makislam/ME100-Toy-Design/inner sleeve.SLDPRT

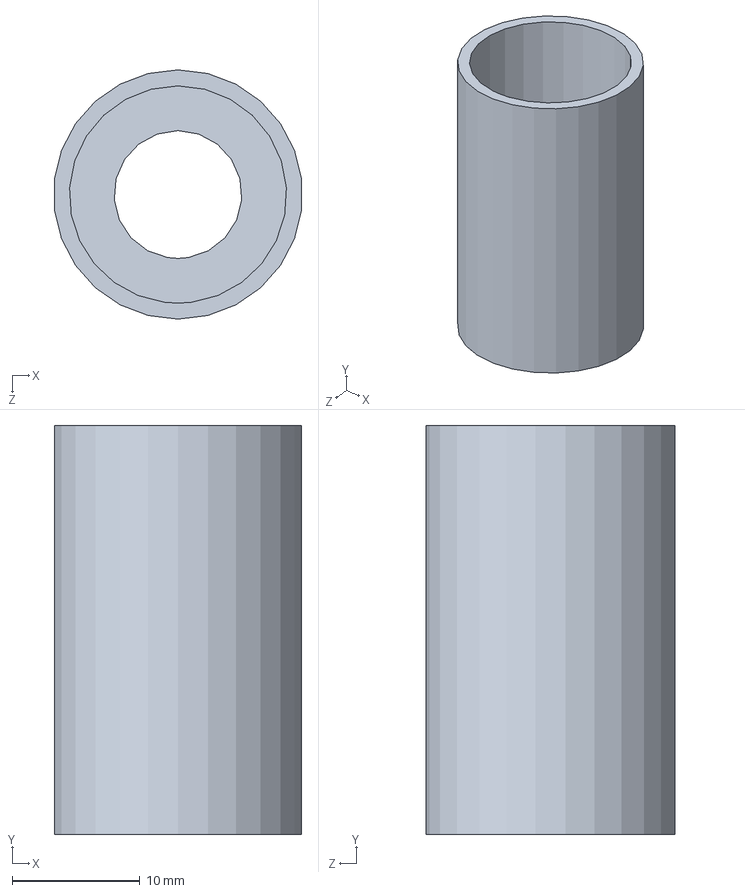
[picture p13: CAD file, 2022-12-06]
inner sleeve.SLDPRT
19.4 x 32.0 x 19.5 mm
