makislam/ME100-Toy-Design/Print files/drive shaft print.STL

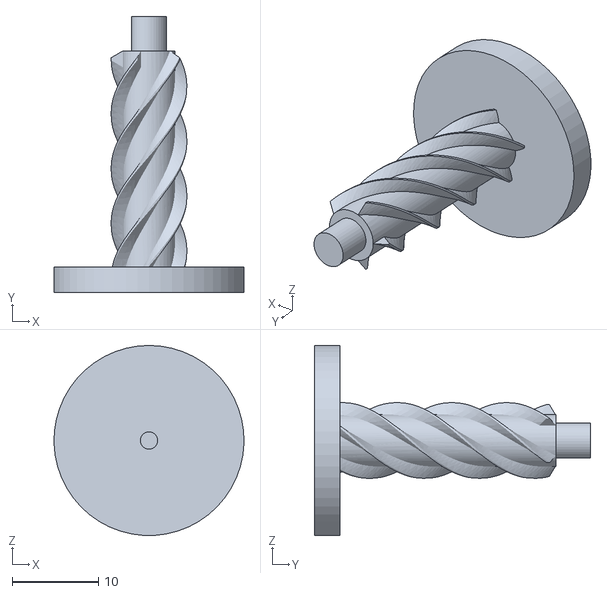
[picture p14: CAD file, 2022-11-29]
Print files/drive shaft print.STL
22.0 x 32.0 x 22.0
