makislam/ME100-Toy-Design/outer sleeve.SLDPRT

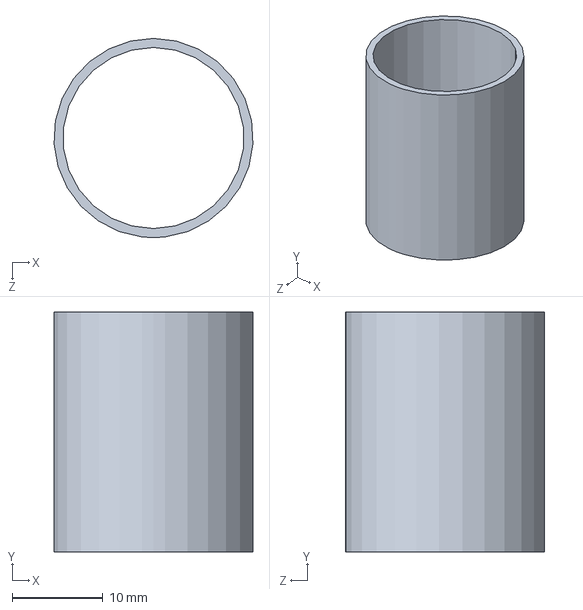
[picture p15: CAD file, 2022-12-06]
outer sleeve.SLDPRT
22.0 x 26.5 x 22.0 mm
