makislam/ME100-Toy-Design/Print files/Inner core print.STL

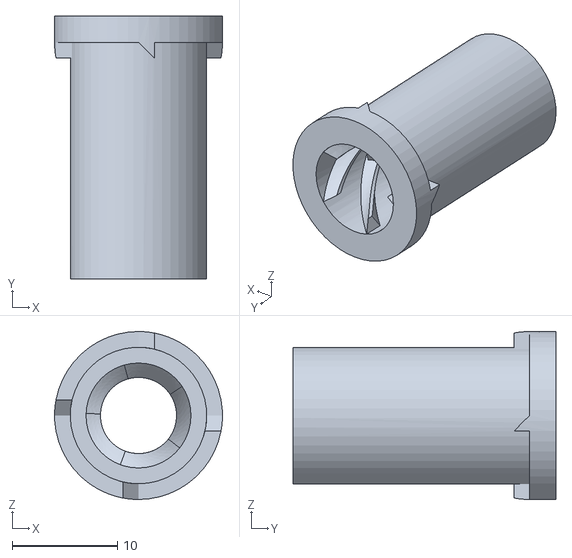
[picture p16: CAD file, 2022-11-29]
Print files/Inner core print.STL
16.0 x 25.0 x 16.0
