makislam/ME100-Toy-Design/outer core.SLDPRT

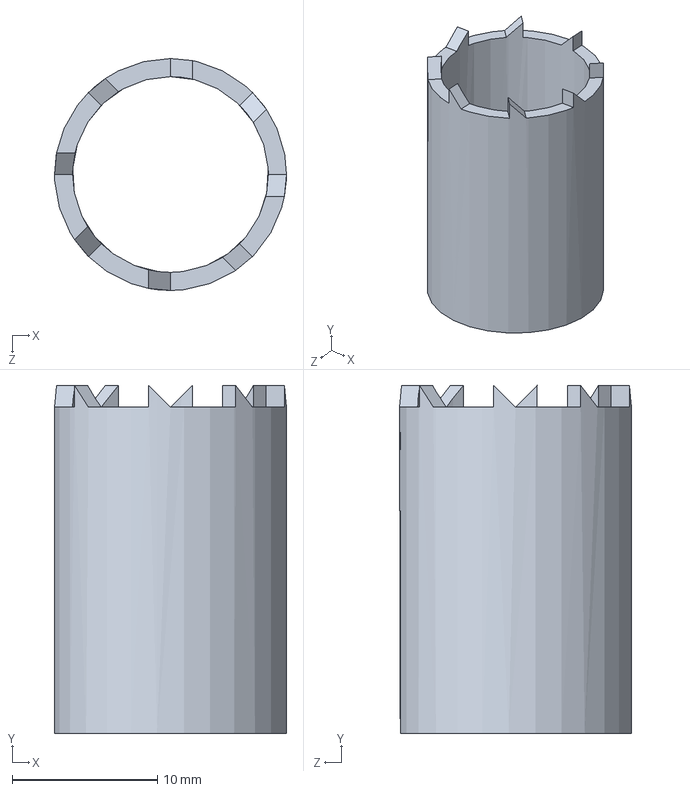
[picture p17: CAD file, 2022-11-29]
outer core.SLDPRT
16.0 x 24.0 x 16.0 mm
