makislam/ME100-Toy-Design/Print files/outer core print.STL

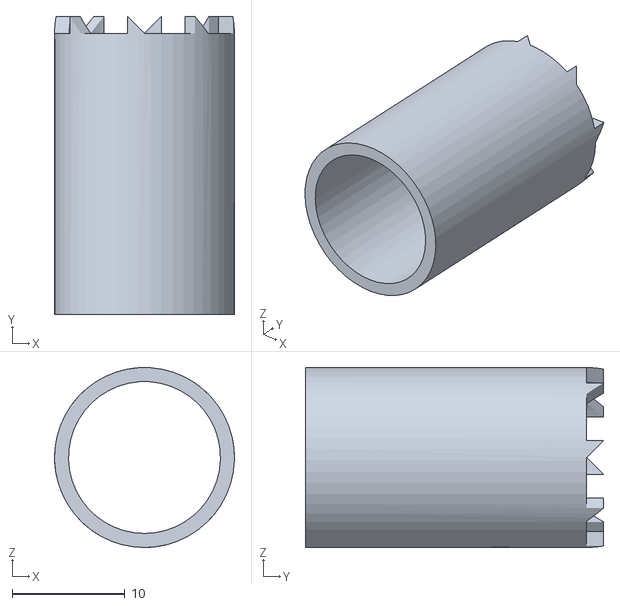
[picture p18: CAD file, 2022-11-29]
Print files/outer core print.STL
16.0 x 26.5 x 16.0
