makislam/ME100-Toy-Design/Print files/top spin print.STL

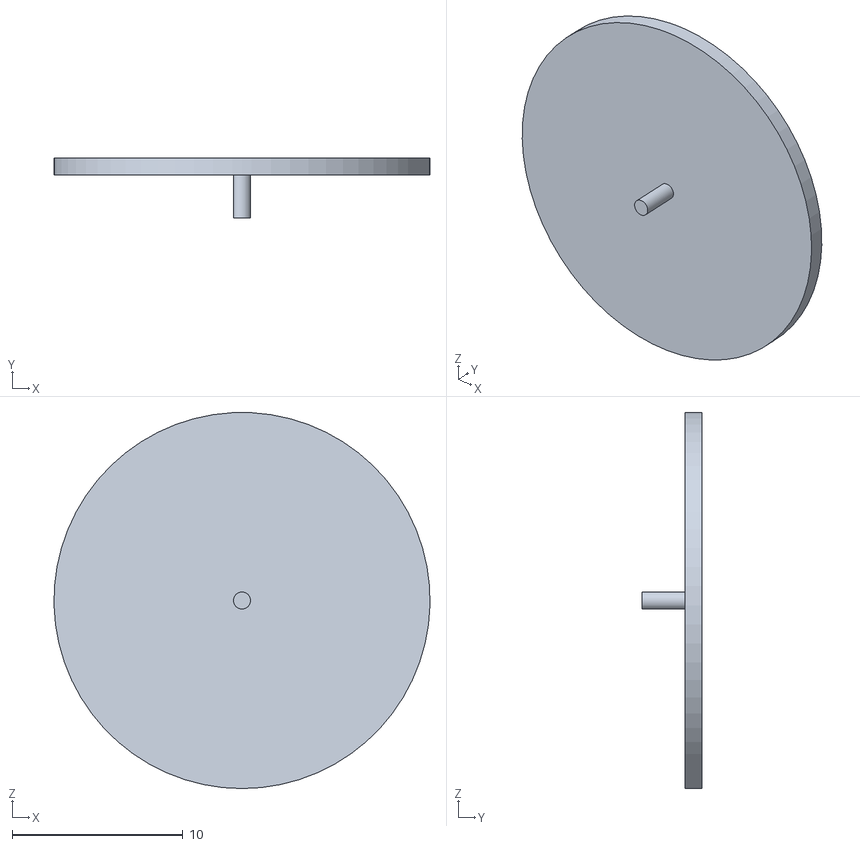
[picture p19: CAD file, 2022-11-29]
Print files/top spin print.STL
22.0 x 3.50 x 22.0
