makislam/ME100-Toy-Design/Drive shaft attatchment.SLDPRT

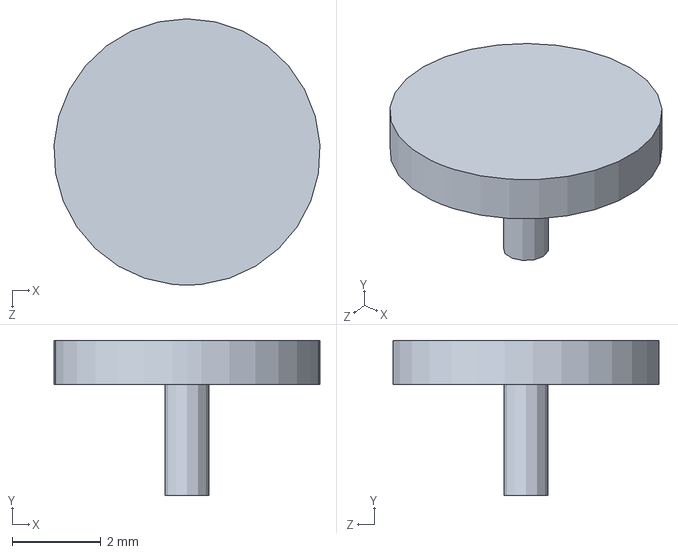
[picture p20: CAD file, 2022-11-29]
Drive shaft attatchment.SLDPRT
5.99 x 3.50 x 6.00 mm
