makislam/ME100-Toy-Design/drive shaft.SLDPRT

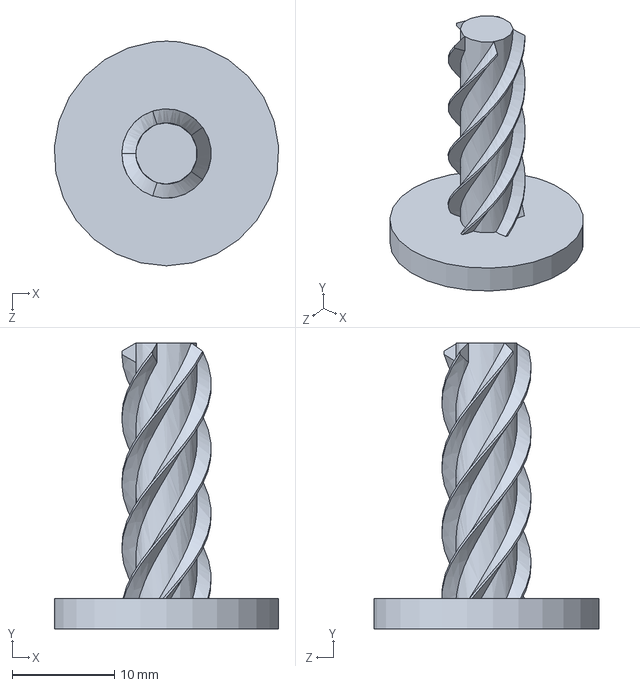
[picture p21: CAD file, 2022-11-29]
drive shaft.SLDPRT
22.0 x 28.0 x 22.0 mm
