makislam/ME100-Toy-Design/bearing model.SLDPRT

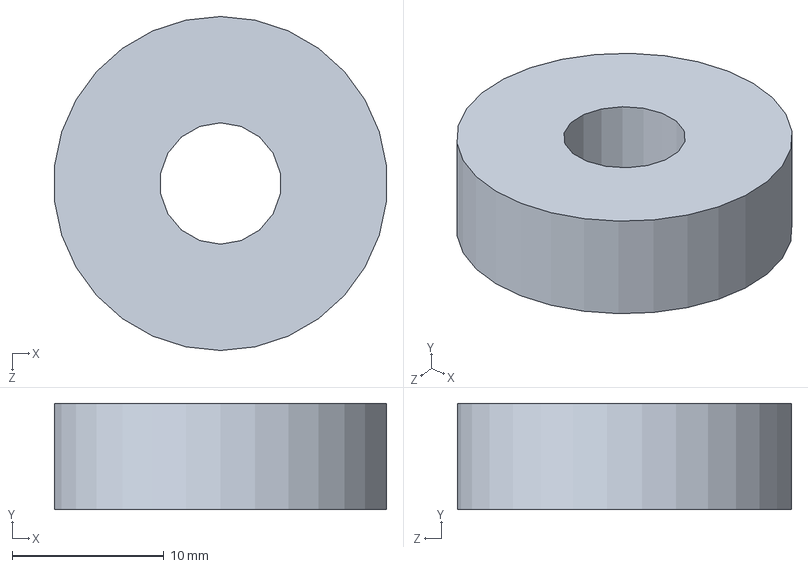
[picture p22: CAD file, 2022-11-29]
bearing model.SLDPRT
21.9 x 7.00 x 22.0 mm
