makislam/ME100-Toy-Design/(list of files, cad)

Other CAD files:
inner core.SLDPRT
Print files/inner sleeve.STL
Print files/outer sleeve.STL
